ethanabraham639/Capstone-2025/README.md

# Capstone-2025

This can have a summary of what each folder contains
