ethanabraham639/Capstone-2025/electrical/README.md

# Electrical

This folder contains the schematic symbol library, pcb footprint library, schematic documents, pcbdoc, etc.
