ethanabraham639/Capstone-2025/electrical/Templates/PuttPilot.png

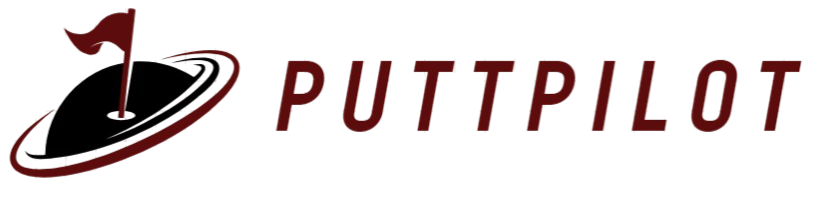
electrical/Templates/PuttPilot.png
