ethanabraham639/Capstone-2025/electrical/PuttPilot-Dev/PuttPilot-Dev.pdf

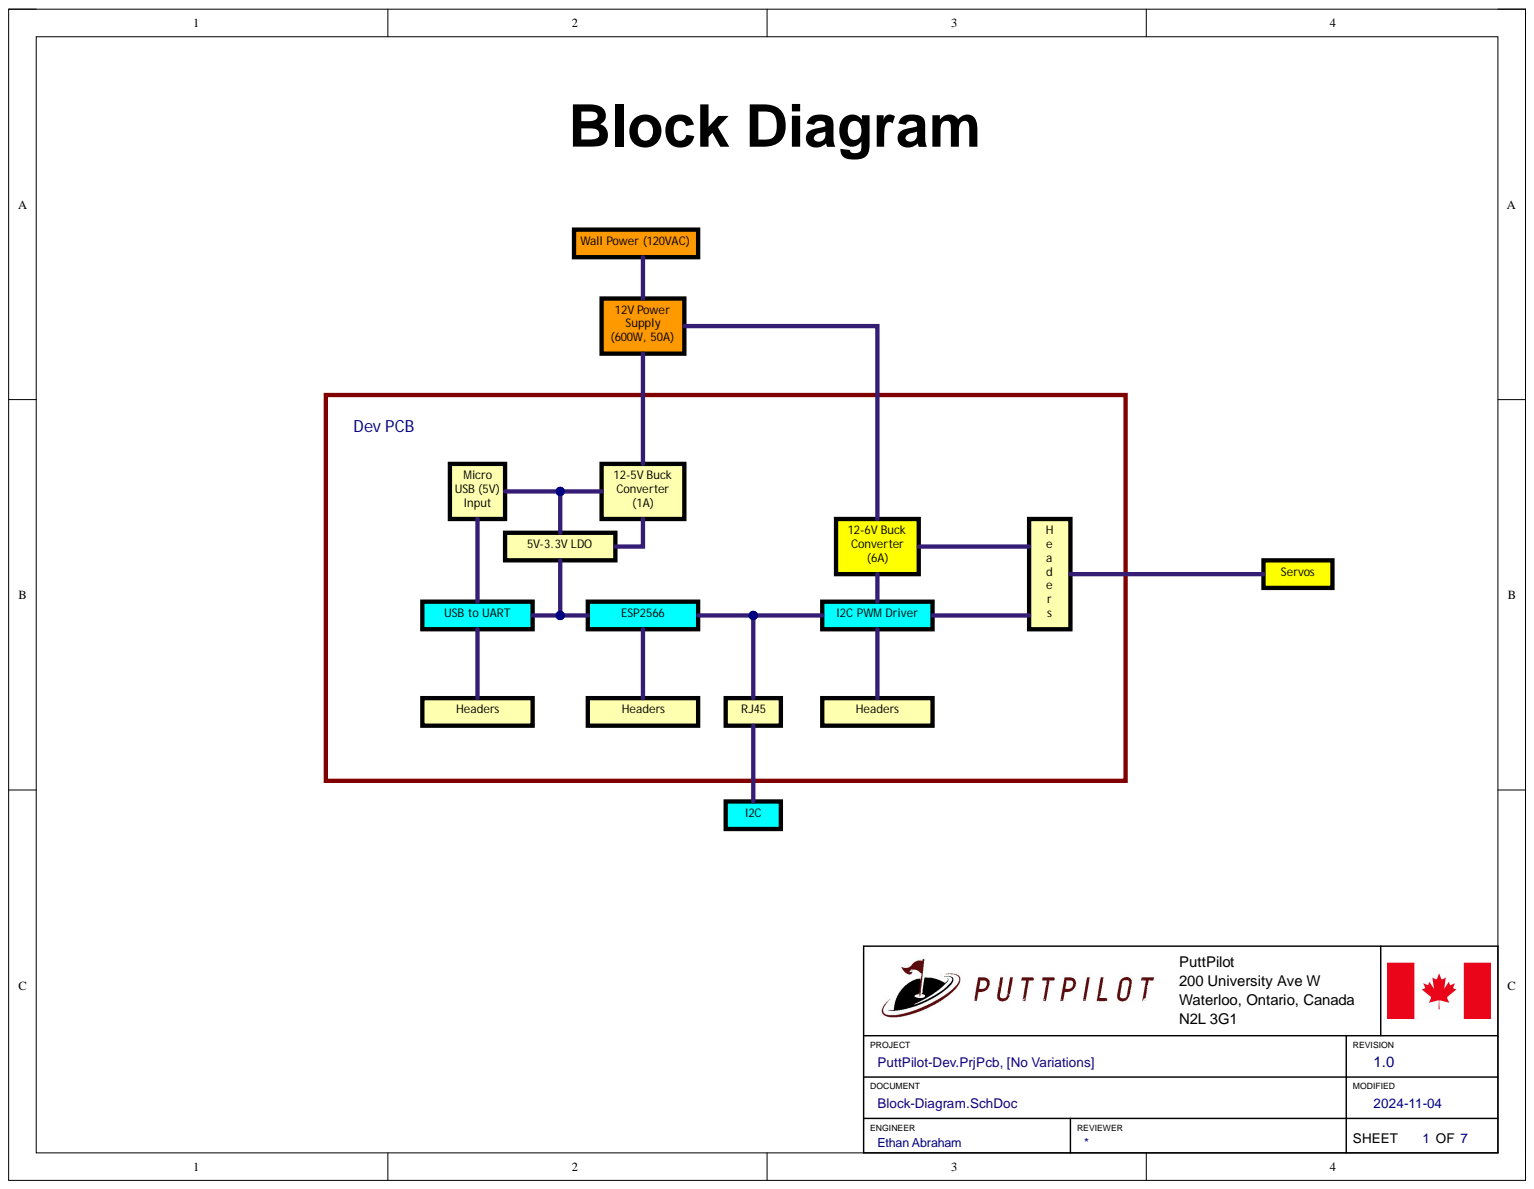
[picture p2: page 1]

PuttPilot 200 University Ave W Waterloo, Ontario, Canada N2L 3G1

PROJECT PuttPilot-Dev.PrjPcb, [No Variations] | REVISION 1.0

DOCUMENT Block-Diagram.SchDoc | MODIFIED 2024-11-04

ENGINEER E | REVIEWER * | SHEET 1 OF 7 than Abraham

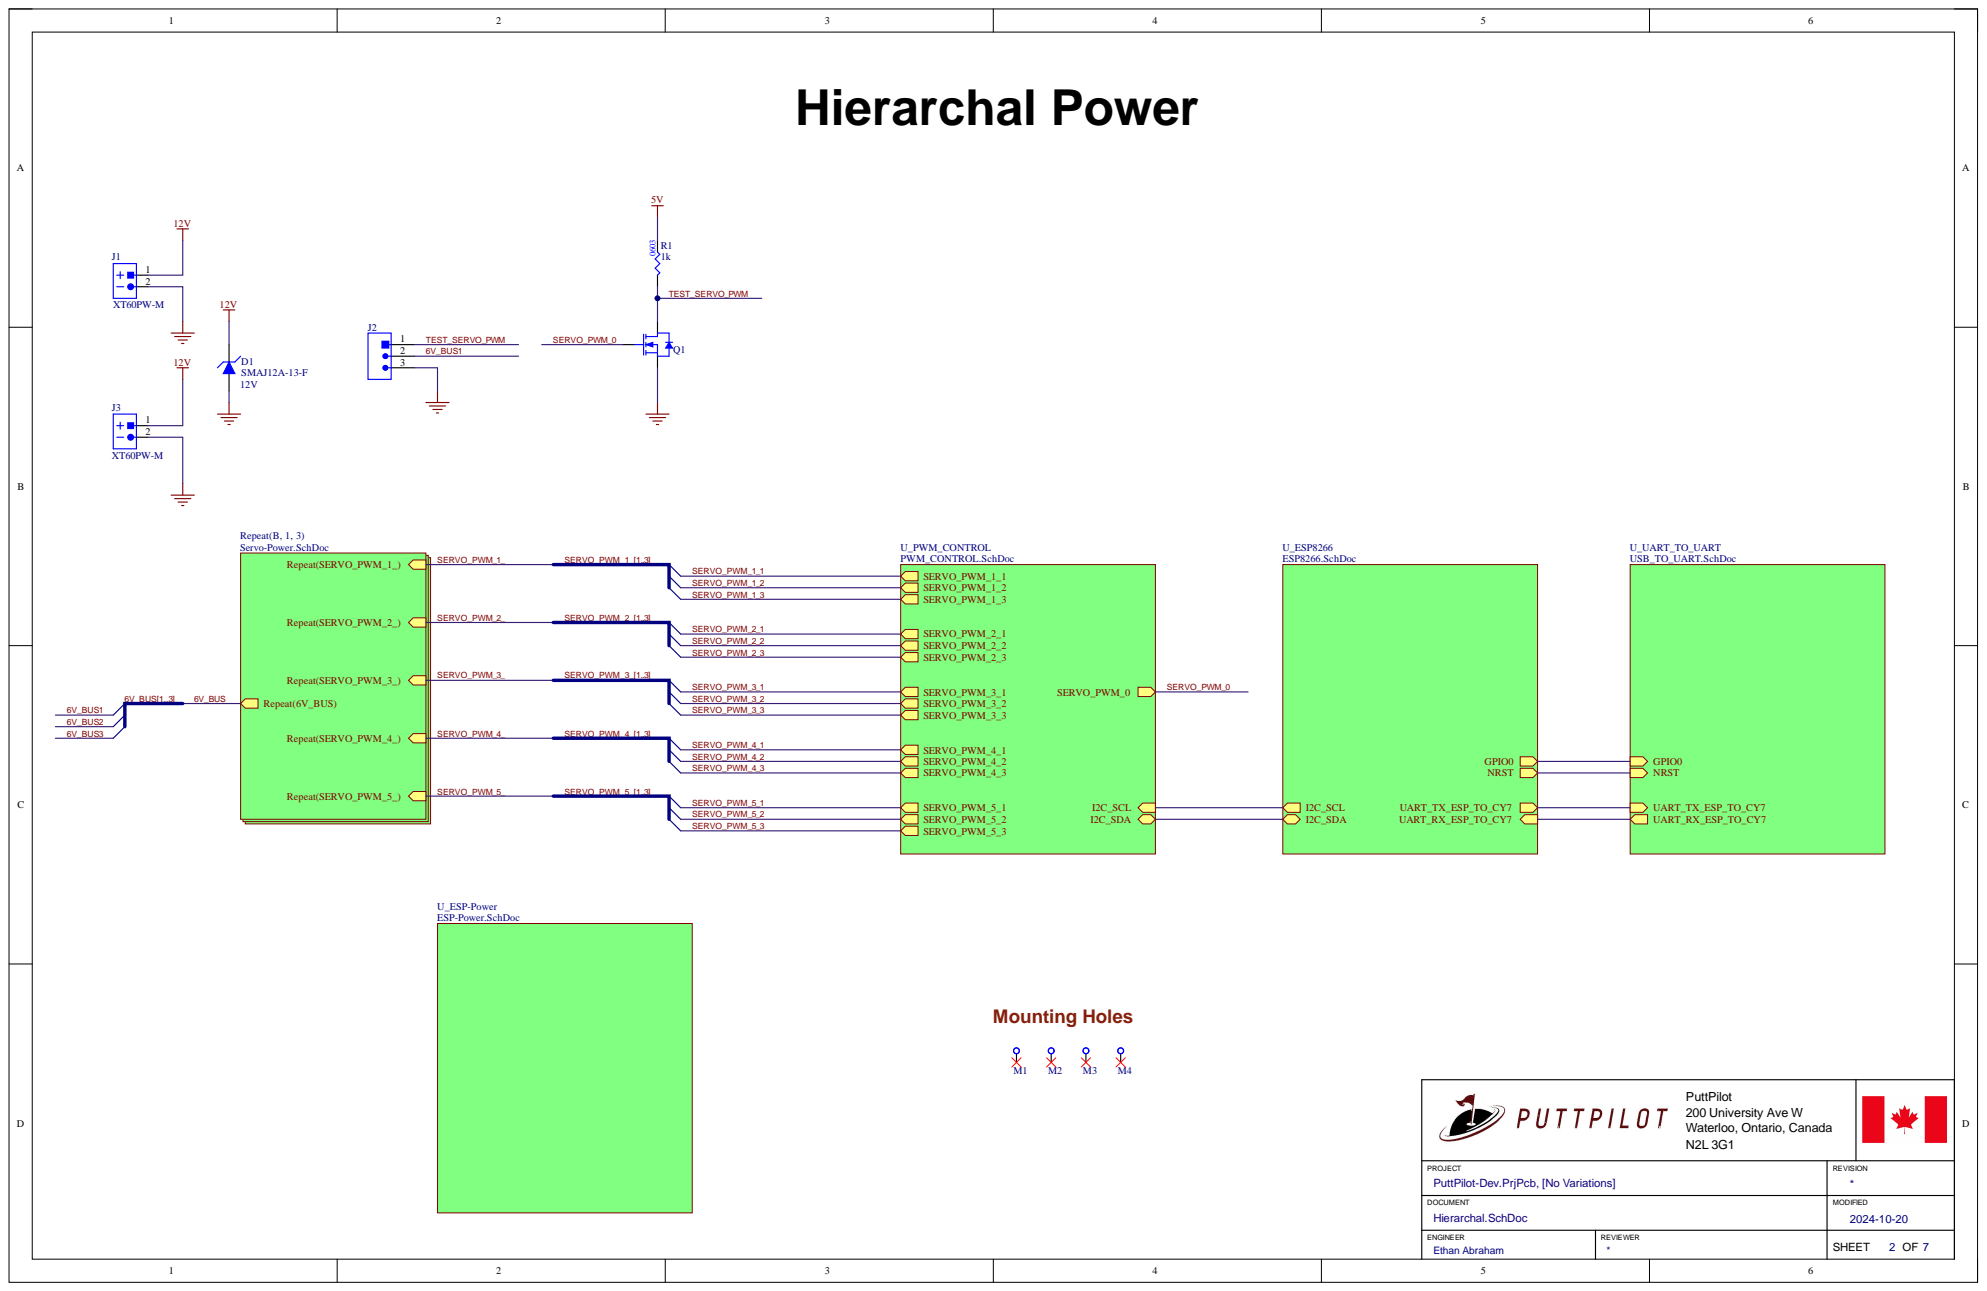
[picture p3: page 2]

PuttPilot 200 University Ave W Waterloo, Ontario, Canada N2L 3G1

PROJECT PuttPilot-Dev.PrjPcb, [No Variations] | REVISION *

DOCUMENT Hierarchal.SchDoc | MODIFIED 2024-10-20

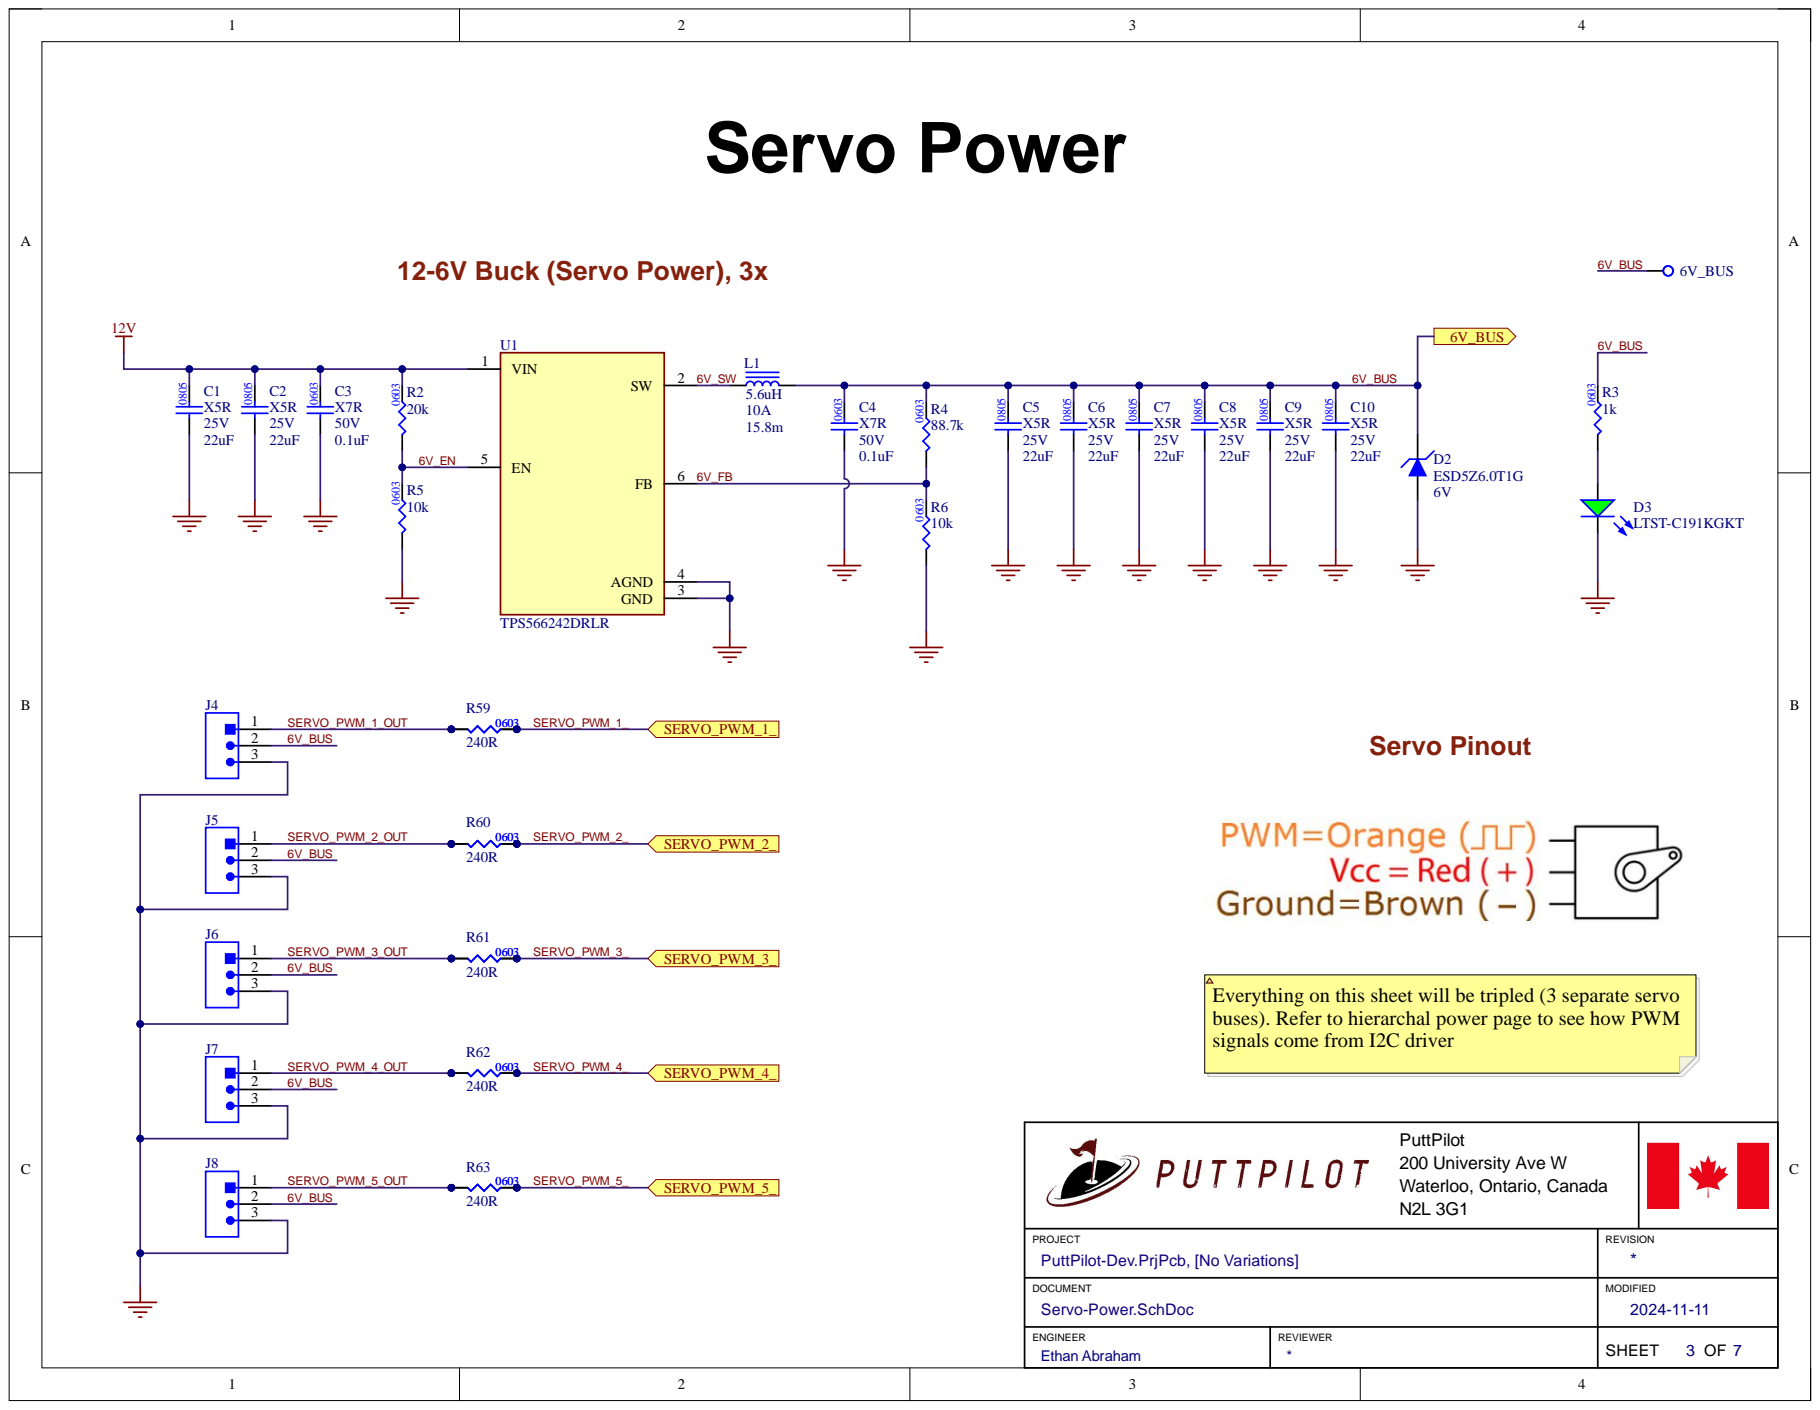
[picture p4: page 3]

Everything on this sheet will be tripled (3 separate servo
buses). Refer to hierarchal power page to see how PWM
signals come from I2C driver

PuttPilot 200 University Ave W Waterloo, Ontario, Canada N2L 3G1

PROJECT PuttPilot-Dev.PrjPcb, [No Variations] | REVISION *

DOCUMENT Servo-Power.SchDoc | MODIFIED

E | | 3 7 than Abraham

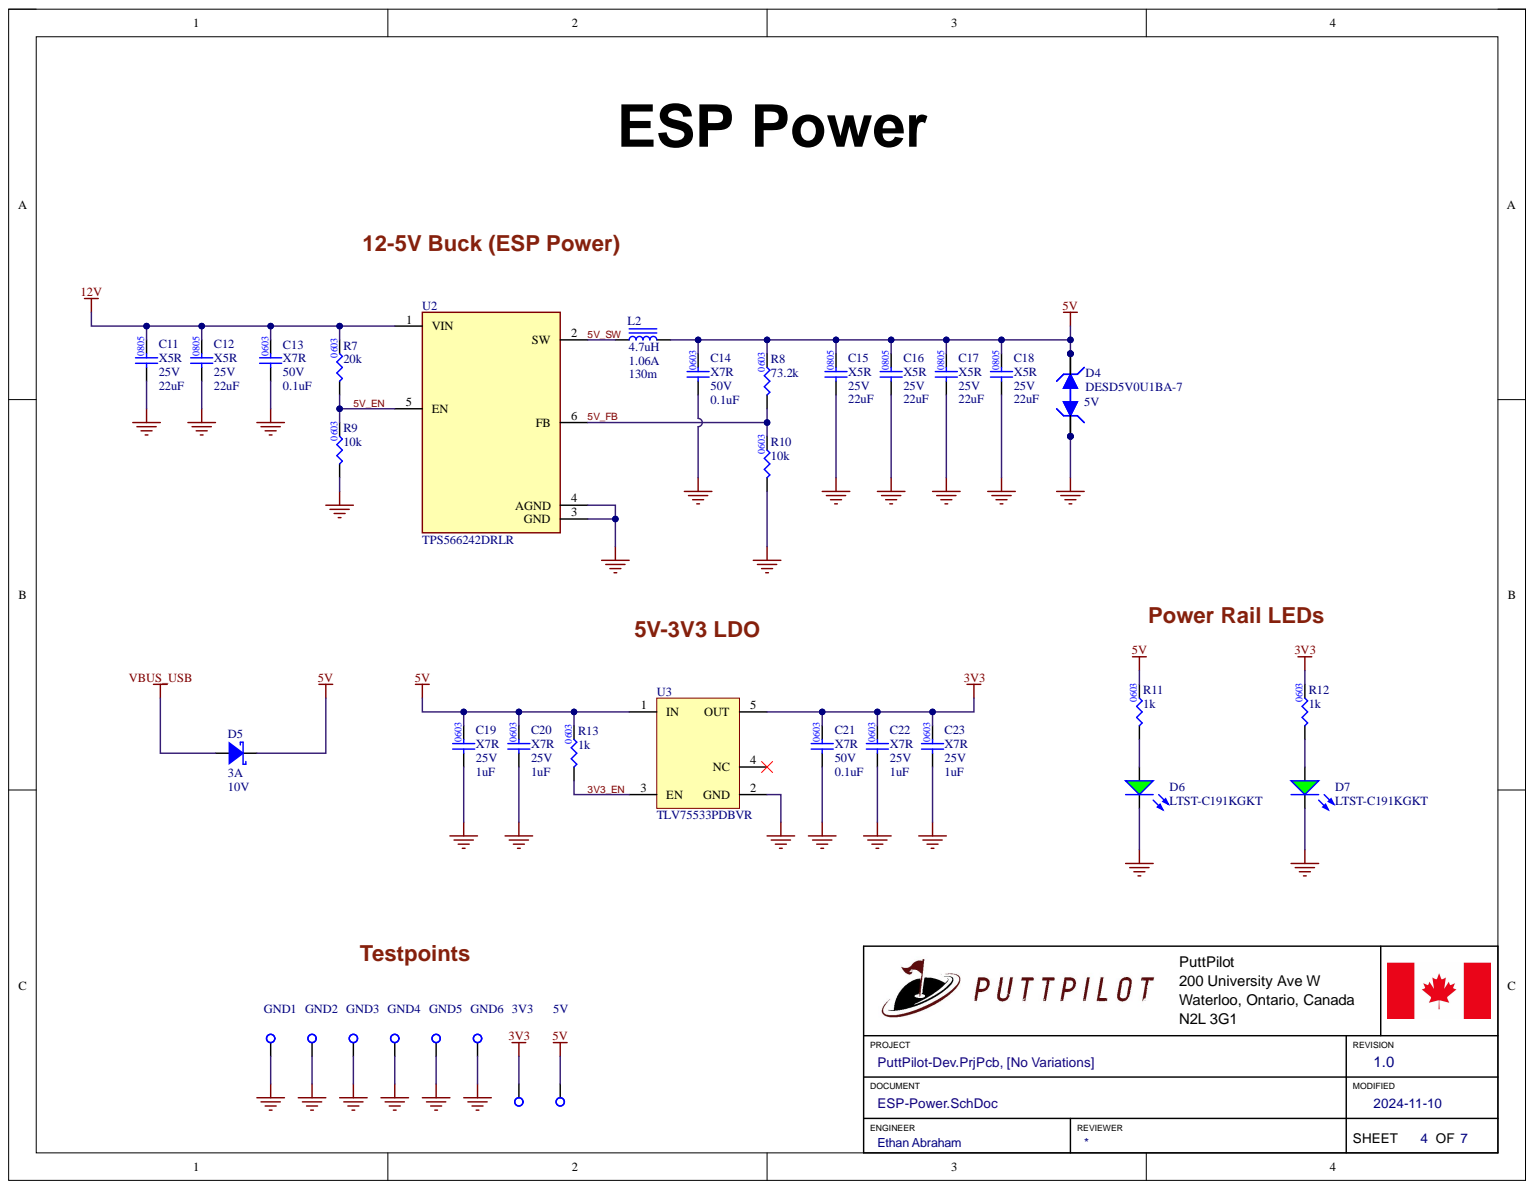
[picture p5: page 4]

PuttPilot 200 University Ave W Waterloo, Ontario, Canada N2L 3G1

PROJECT PuttPilot-Dev.PrjPcb, [No Variations] | REVISION 1.0

DOCUMENT ESP-Power.SchDoc | MODIFIED

E | | 4 7 than Abraham

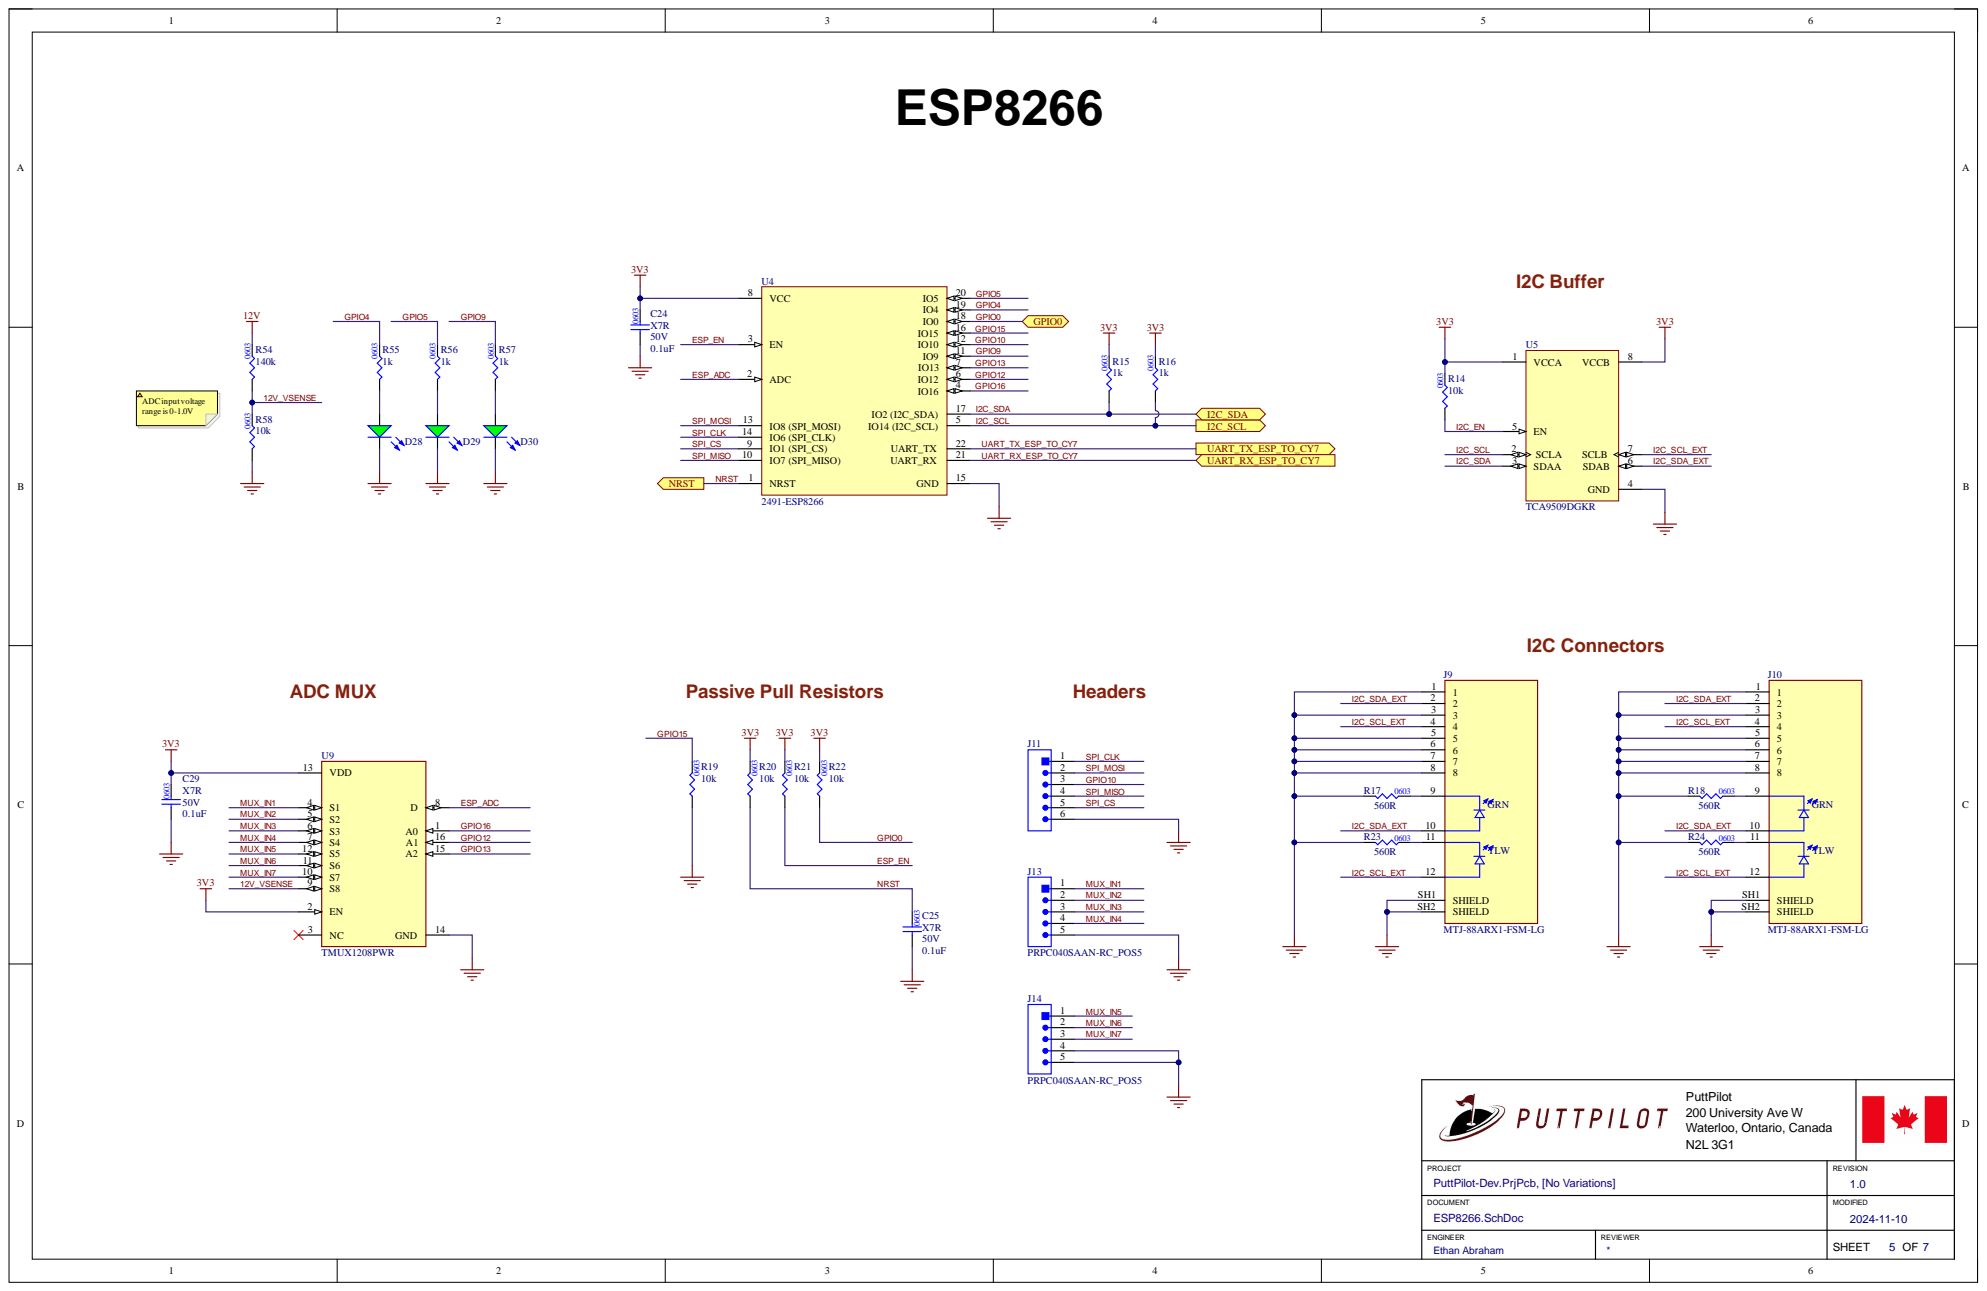
[picture p6: page 5]

PuttPilot 200 University Ave W Waterloo, Ontario, Canada N2L 3G1

PROJECT PuttPilot-Dev.PrjPcb, [No Variations] | REVISION 1.0

DOCUMENT ESP8266.SchDoc | MODIFIED 2024-11-10

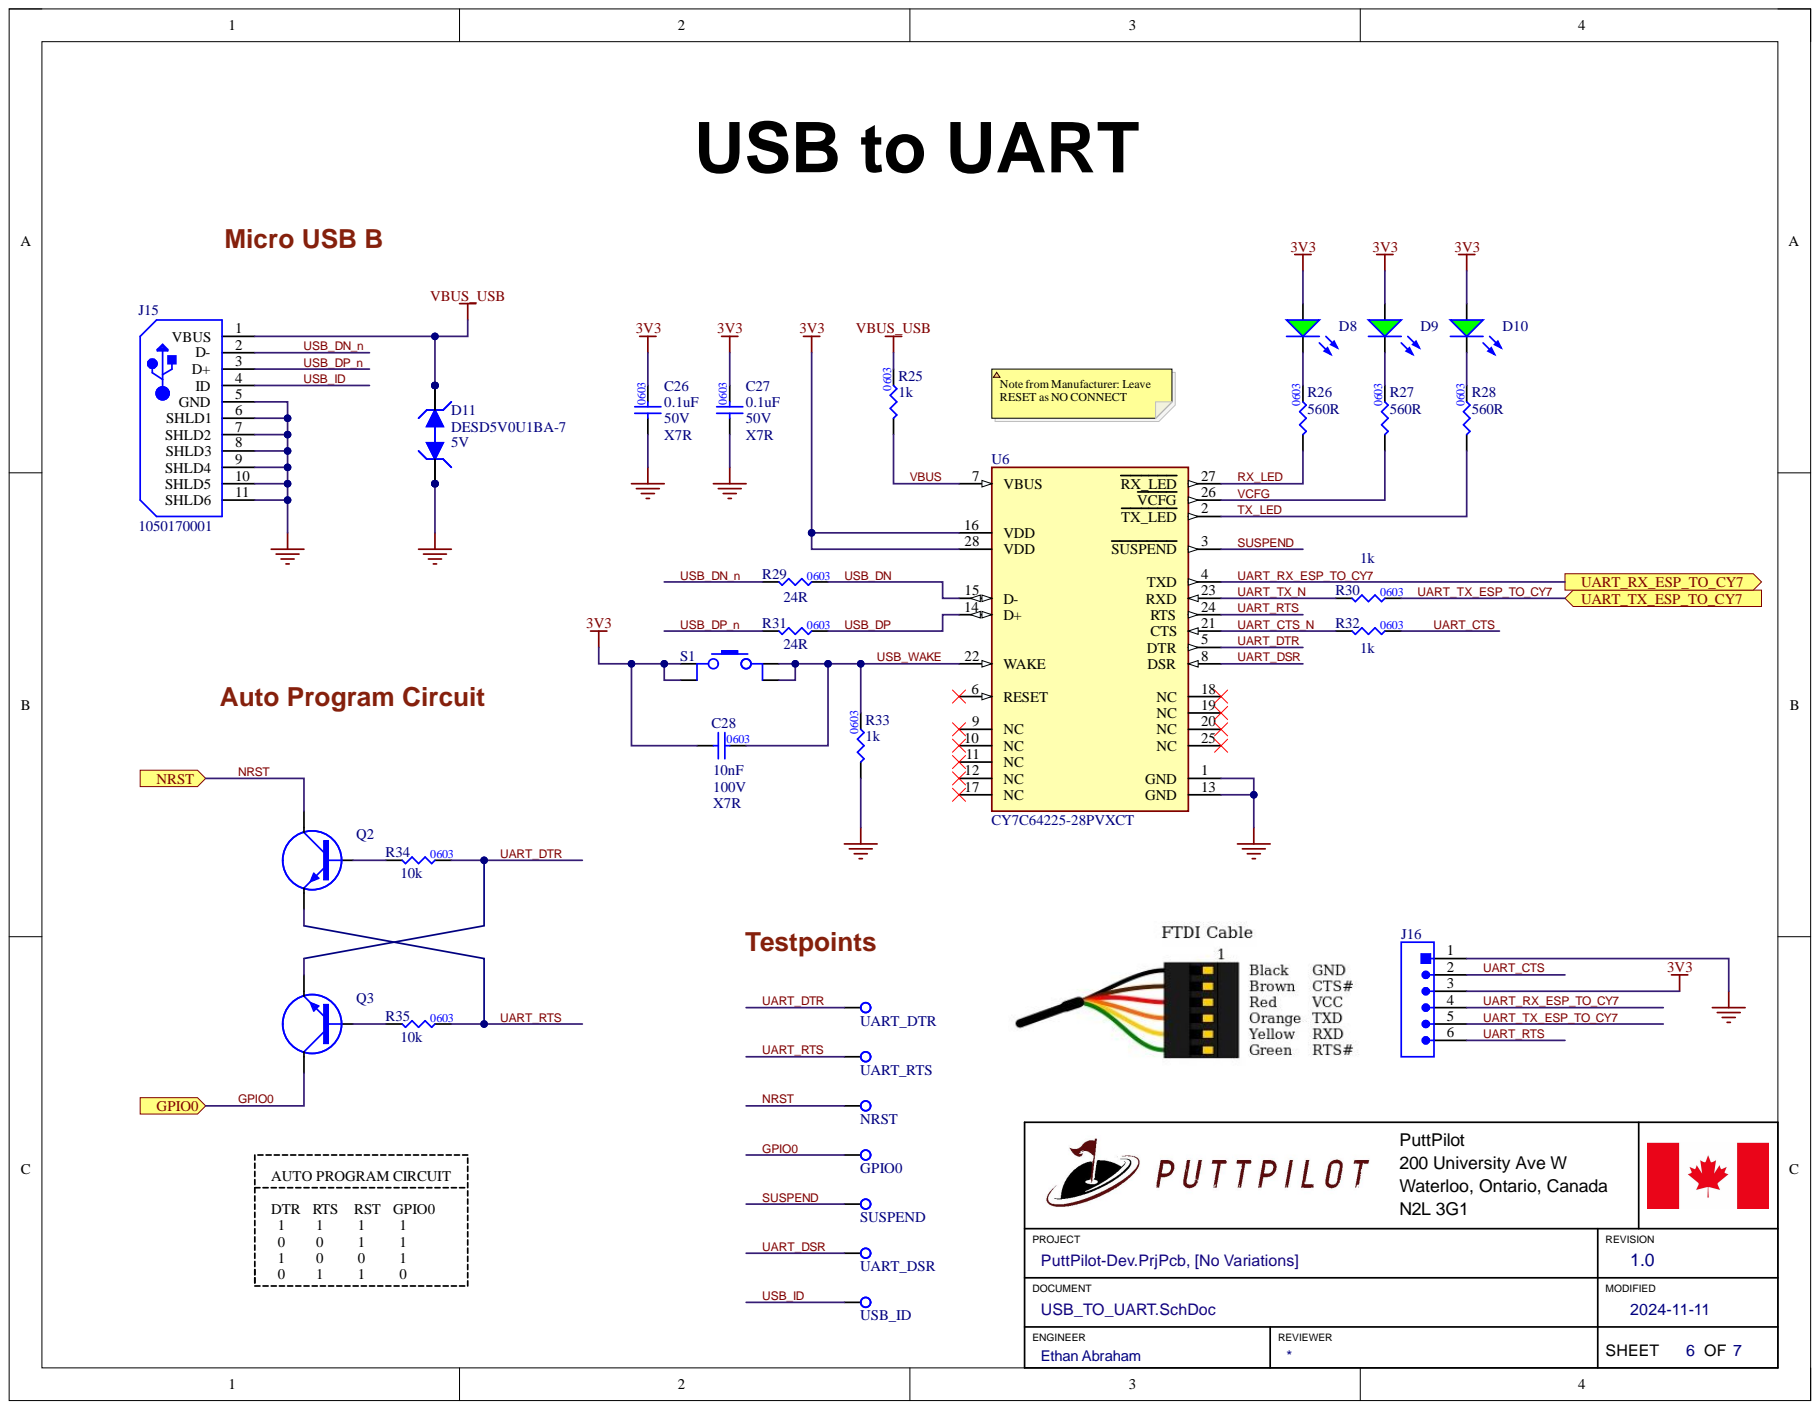
[picture p7: page 6]

Note from Manufacturer: Leave
RESET as NO CONNECT

USB_DP | WAKE 22

PuttPilot 200 University Ave W Waterloo, Ontario, Canada N2L 3G1

PROJECT PuttPilot-Dev.PrjPcb, [No Variations] | REVISION 1.0

DOCUMENT USB_TO_UART.SchDoc | MODIFIED

E | | 6 7 than Abraham

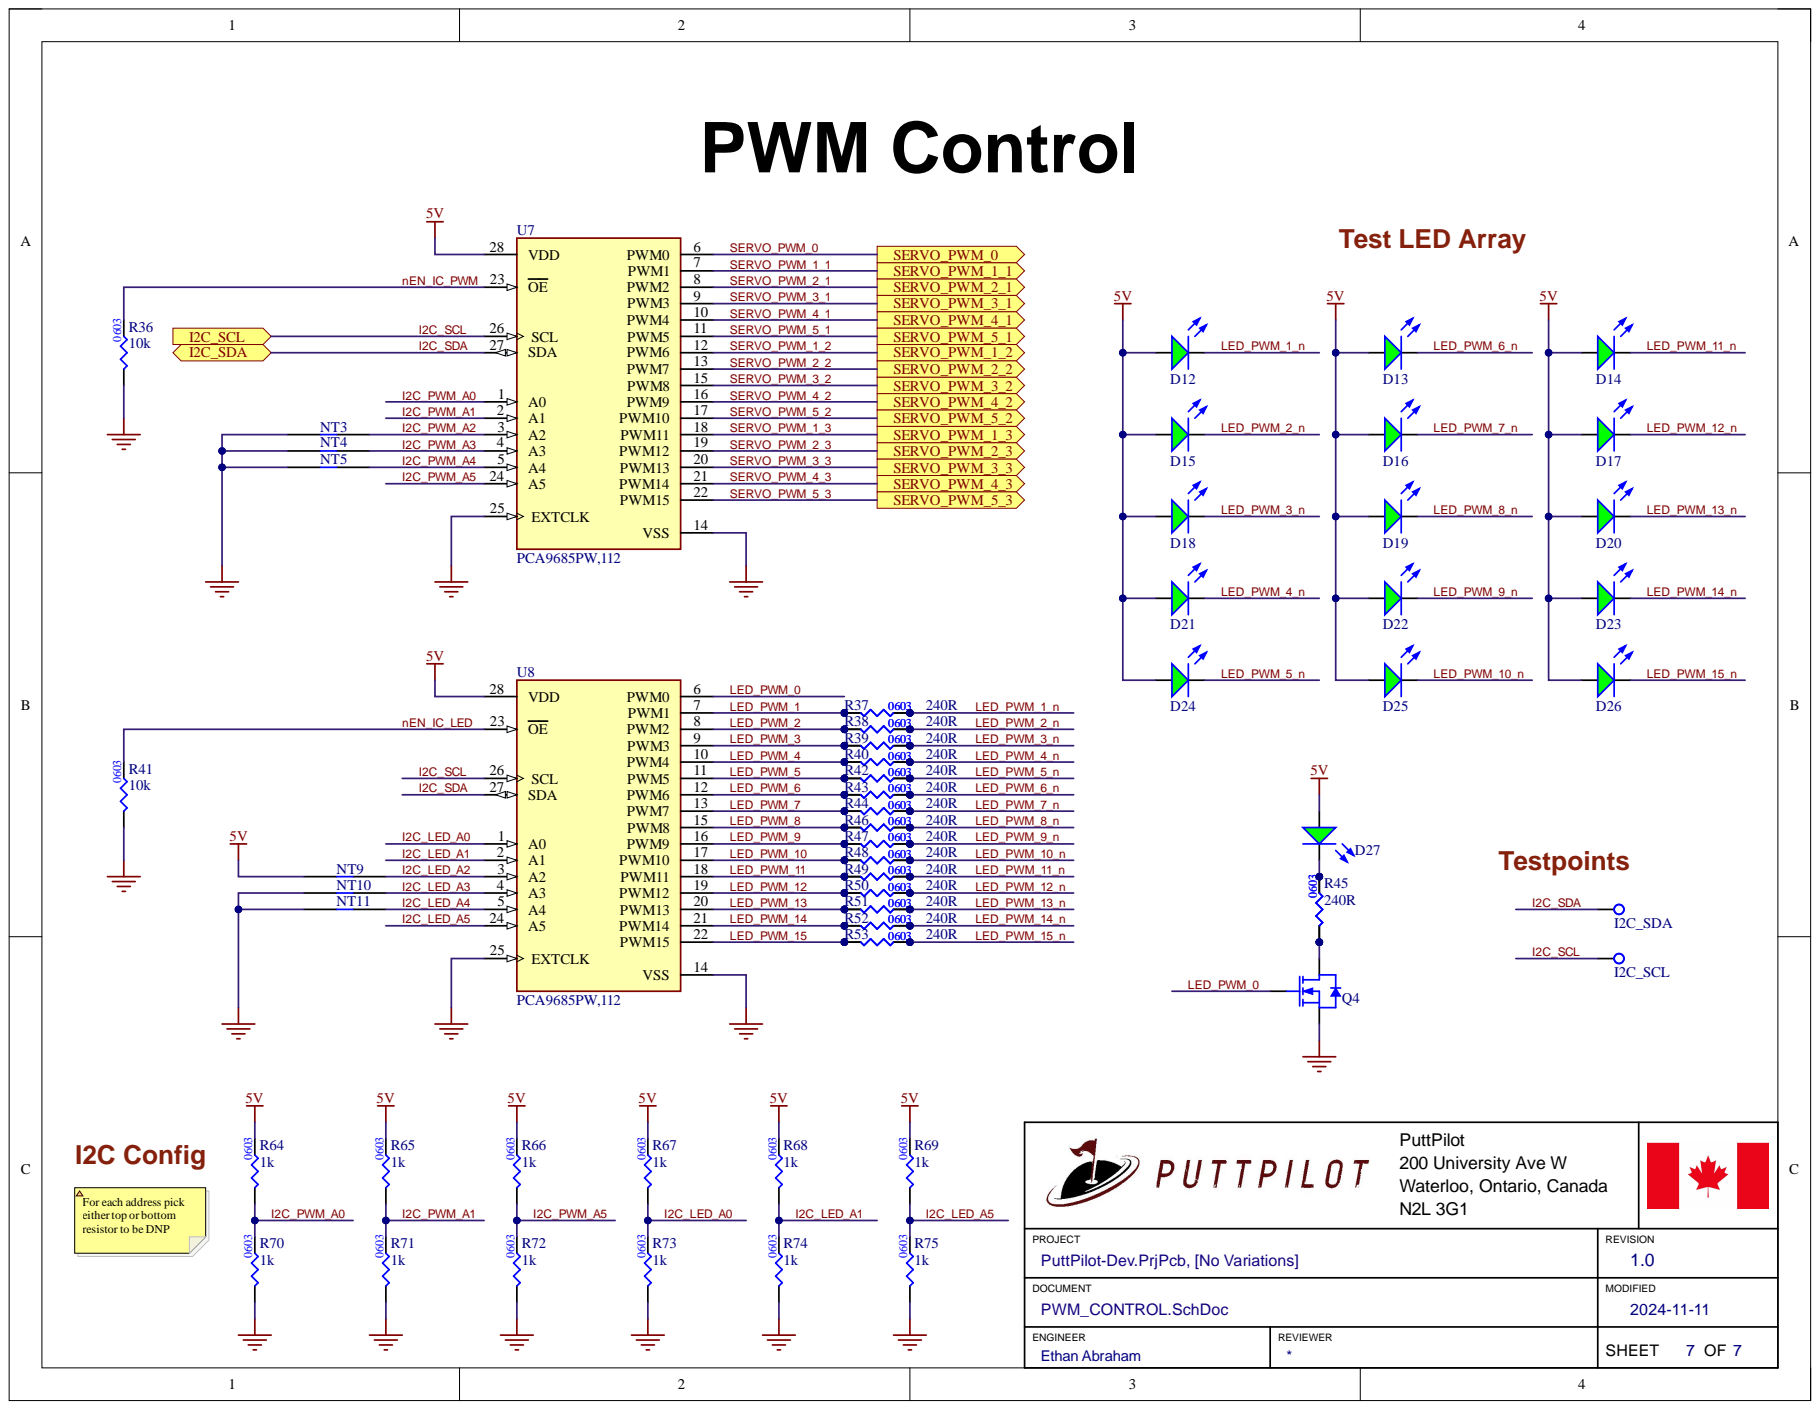
[picture p8: page 7]

NT4 I2C_PWM_A3 | A3 4
NT5 I2C_PWM_A4 | A4 5

I2C_PWM_A5 | A5 24

NT11 I2C_LED_A4 | A4 5

I2C_LED_A5 | A5 24

PuttPilot 200 University Ave W Waterloo, Ontario, Canada N2L 3G1

For each address pick
either top or bottom
resistor to be DNP

PROJECT PuttPilot-Dev.PrjPcb, [No Variations] | REVISION 1.0

DOCUMENT PWM_CONTROL.SchDoc | MODIFIED

E | | 7 7 than Abraham

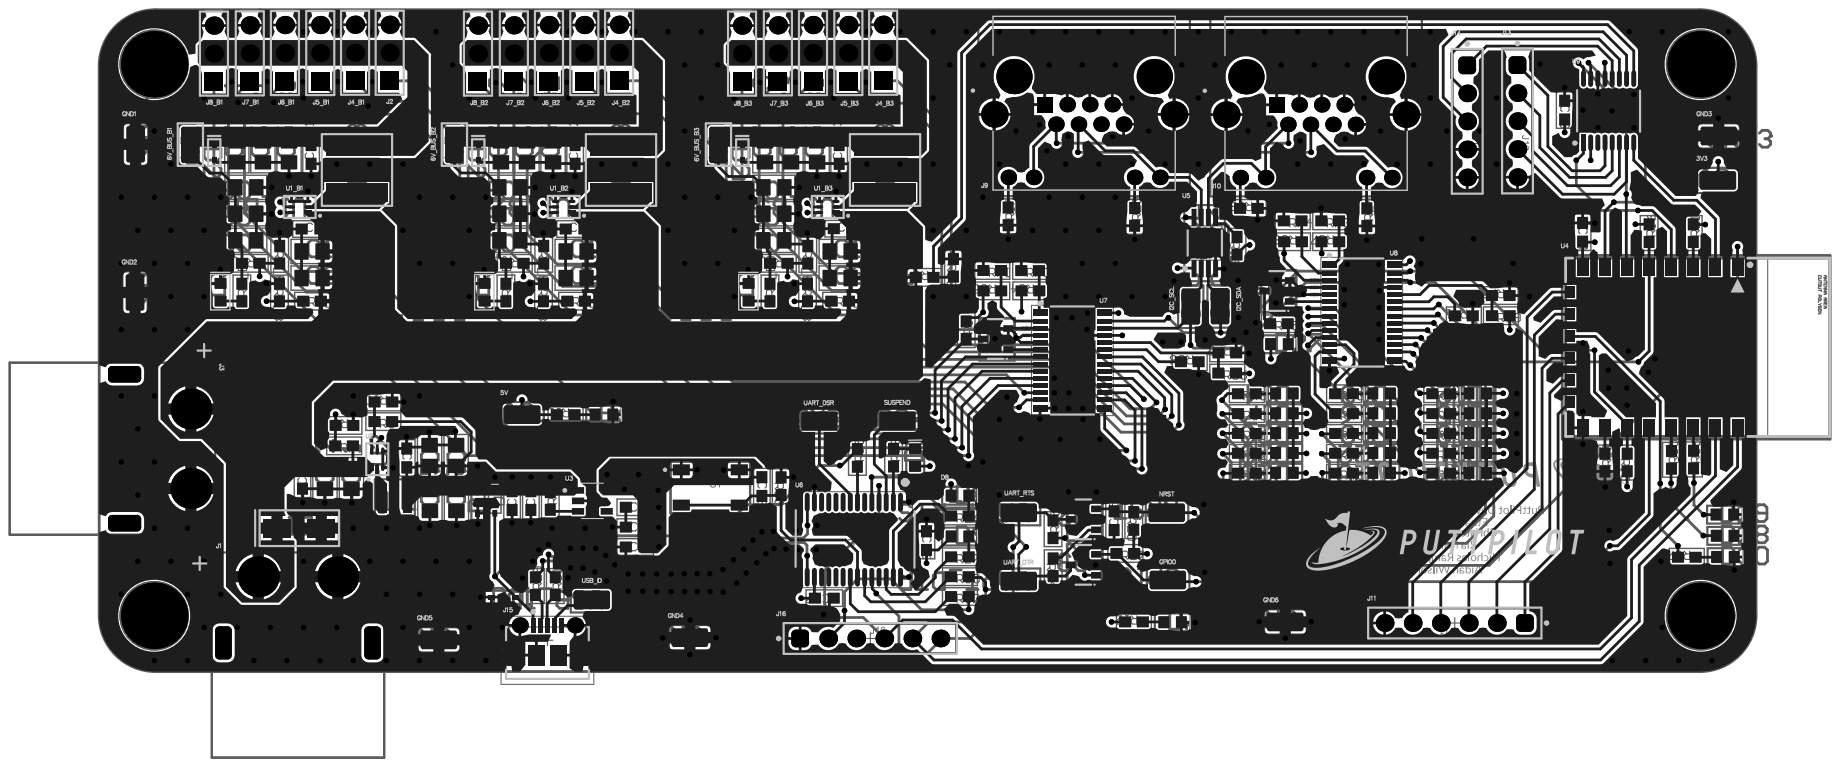
[picture p9: page 8]

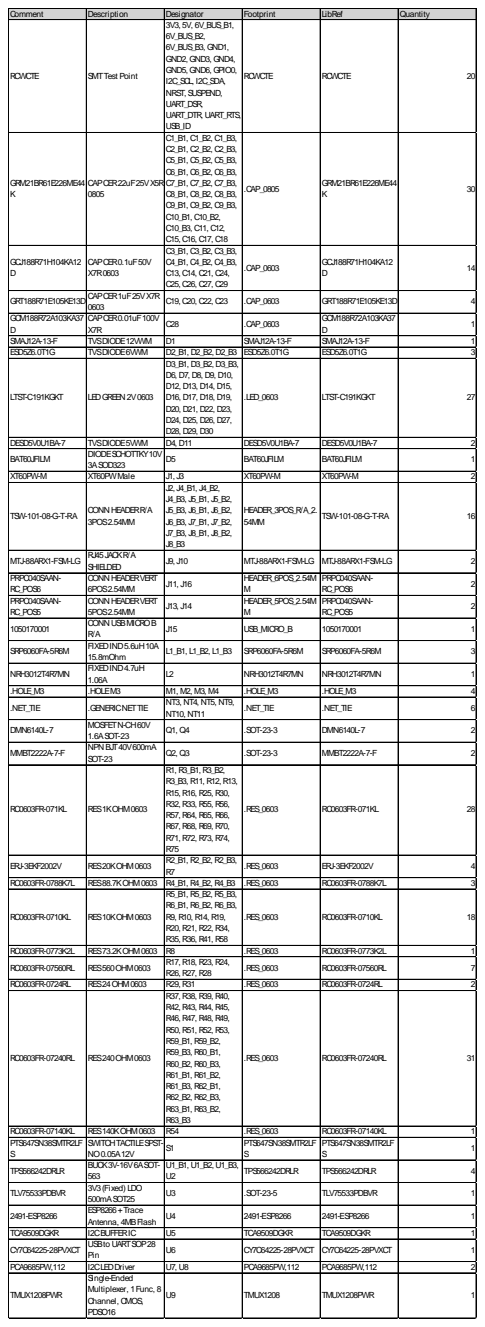
[picture p10: page 9]

Comment | Description | Designator | Footprint | LibRef | Quantity
RCWCTE | SMTTest Point | 3V3, 5V, 6V_BUS_B1, 6V_BUS_B2, 6V_BUS_B3, GND1, GND2, GND3, GND4, GND5, GND6, GPIO0, I2C_SCL, I2C_SDA, NRST, SUSPEND, UART_DSR, UART_DTR, UART_RTS, USB_ID | RCWCTE | RCWCTE | 20

GRM21BR61E226ME44 K | CAPCER22uF25VX5R 0805 | C1_B1, C1_B2, C1_B3, C2_B1, C2_B2, C2_B3, C5_B1, C5_B2, C5_B3, C6_B1, C6_B2, C6_B3, C7_B1, C7_B2, C7_B3, C8_B1, C8_B2, C8_B3, C9_B1, C9_B2, C9_B3, C10_B1, C10_B2, C10_B3, C11, C12, C15, C16, C17, C18 | .CAP_0805 | GRM21BR61E226ME44 K | 30

GCJ188R71H104KA12 D | CAPCER0.1uF50V X7R0603 | C3_B1, C3_B2, C3_B3, C4_B1, C4_B2, C4_B3, C13, C14, C21, C24, C25, C26, C27, C29 | .CAP_0603 | GCJ188R71H104KA12 D | 14

GRT188R71E105KE13D CAPCER1uF25VX7R | 0603 | C19, C20, C22, C23 | .CAP_0603 | GRT188R71E105KE13D | 4

GCM188R72A103KA37 D | CAPCER0.01uF100V X7R | C28 | .CAP_0603 | GCM188R72A103KA37 D | 1

SMAJ12A-13-F | TVSDIODE12VWM | D1 | SMAJ12A-13-F | SMAJ12A-13-F | 1
ESD5Z6.0T1G | TVSDIODE6VWM | D2_B1, D2_B2, D2_B3 | ESD5Z6.0T1G | ESD5Z6.0T1G | 3
LTST-C191KGKT | LEDGREEN 2V0603 | D3_B1, D3_B2, D3_B3, D6, D7, D8, D9, D10, D12, D13, D14, D15, D16, D17, D18, D19, D20, D21, D22, D23, D24, D25, D26, D27, D28, D29, D30 | .LED_0603 | LTST-C191KGKT | 27

DESD5V0U1BA-7 | TVSDIODE5VWM | D4, D11 | DESD5V0U1BA-7 | DESD5V0U1BA-7 | 2
BAT60JFILM | DIODESCHOTTKY10V 3ASOD323 | D5 | BAT60JFILM | BAT60JFILM | 1

XT60PW-M | XT60PWMale | J1, J3 | XT60PW-M | XT60PW-M | 2
TSW-101-08-G-T-RA | CONN HEADERR/A 3POS2.54MM | J2, J4_B1, J4_B2, J4_B3, J5_B1, J5_B2, J5_B3, J6_B1, J6_B2, J6_B3, J7_B1, J7_B2, J7_B3, J8_B1, J8_B2, J8_B3 | HEADER_3POS_R/A_2. 54MM | TSW-101-08-G-T-RA | 16

MTJ-88ARX1-FSM-LG | RJ45JACKR/A SHIELDED | J9, J10 | MTJ-88ARX1-FSM-LG | MTJ-88ARX1-FSM-LG | 2

PRPC040SAAN-RC_POS6 | CONN HEADERVERT 6POS2.54MM | J11, J16 | HEADER_6POS_2.54M M | PRPC040SAAN-RC_POS6 | 2

PRPC040SAAN-RC_POS5 | CONN HEADERVERT 5POS2.54MM | J13, J14 | HEADER_5POS_2.54M M | PRPC040SAAN-RC_POS5 | 2

1050170001 | CONN USBMICROB R/A | J15 | USB_MICRO_B | 1050170001 | 1

SRP6060FA-5R6M | FIXEDIND5.6uH10A 15.8mOhm | L1_B1, L1_B2, L1_B3 | SRP6060FA-5R6M | SRP6060FA-5R6M | 3

NRH3012T4R7MN | FIXEDIND4.7uH 1.06A | L2 | NRH3012T4R7MN | NRH3012T4R7MN | 1

.HOLE_M3 | .HOLEM3 | M1, M2, M3, M4 | .HOLE_M3 | .HOLE_M3 | 4
.NET_TIE | .GENERICNETTIE | NT3, NT4, NT5, NT9, NT10, NT11 | .NET_TIE | .NET_TIE | 6

DMN6140L-7 | MOSFETN-CH60V 1.6ASOT-23 | Q1, Q4 | .SOT-23-3 | DMN6140L-7 | 2

MMBT2222A-7-F | NPN BJT40V600mA SOT-23 | Q2, Q3 | .SOT-23-3 | MMBT2222A-7-F | 2

RC0603FR-071KL | RES1KOHM0603 | R1, R3_B1, R3_B2, R3_B3, R11, R12, R13, R15, R16, R25, R30, R32, R33, R55, R56, R57, R64, R65, R66, R67, R68, R69, R70, R71, R72, R73, R74, R75 | .RES_0603 | RC0603FR-071KL | 28

ERJ-3EKF2002V | RES20KOHM0603 | R2_B1, R2_B2, R2_B3, R7 | .RES_0603 | ERJ-3EKF2002V | 4

RC0603FR-0788K7L | RES88.7KOHM0603 | R4_B1, R4_B2, R4_B3 | .RES_0603 | RC0603FR-0788K7L | 3
RC0603FR-0710KL | RES10KOHM0603 | R5_B1, R5_B2, R5_B3, R6_B1, R6_B2, R6_B3, R9, R10, R14, R19, R20, R21, R22, R34, R35, R36, R41, R58 | .RES_0603 | RC0603FR-0710KL | 18

RC0603FR-0773K2L | RES73.2KOHM0603 | R8 | .RES_0603 | RC0603FR-0773K2L | 1
RC0603FR-07560RL | RES560OHM0603 | R17, R18, R23, R24, R26, R27, R28 | .RES_0603 | RC0603FR-07560RL | 7

RC0603FR-0724RL | RES24OHM0603 | R29, R31 | .RES_0603 | RC0603FR-0724RL | 2
RC0603FR-07240RL | RES240OHM0603 | R37, R38, R39, R40, R42, R43, R44, R45, R46, R47, R48, R49, R50, R51, R52, R53, R59_B1, R59_B2, R59_B3, R60_B1, R60_B2, R60_B3, R61_B1, R61_B2, R61_B3, R62_B1, R62_B2, R62_B3, R63_B1, R63_B2, R63_B3 | .RES_0603 | RC0603FR-07240RL | 31

RC0603FR-07140KL | RES140KOHM0603 | R54 | .RES_0603 | RC0603FR-07140KL | 1
PTS647SN38SMTR2LF S | SWITCHTACTILESPST-NO0.05A12V | S1 | PTS647SN38SMTR2LF S | PTS647SN38SMTR2LF S | 1

TPS566242DRLR | BUCK3V-16V6ASOT-563 | U1_B1, U1_B2, U1_B3, U2 | TPS566242DRLR | TPS566242DRLR | 4

TLV75533PDBVR | 3V3(Fixed) LDO 500mASOT25 | U3 | .SOT-23-5 | TLV75533PDBVR | 1

2491-ESP8266 | ESP8266+Trace Antenna, 4MBFlash | U4 | 2491-ESP8266 | 2491-ESP8266 | 1

TCA9509DGKR | I2CBUFFERIC | U5 | TCA9509DGKR | TCA9509DGKR | 1
CY7C64225-28PVXCT | USBto UARTSOP28 Pin | U6 | CY7C64225-28PVXCT | CY7C64225-28PVXCT | 1

PCA9685PW,112 | I2CLEDDriver | U7, U8 | PCA9685PW,112 | PCA9685PW,112 | 2
TMUX1208PWR | Single-Ended Multiplexer, 1Func, 8 Channel, CMOS, PDSO16 | U9 | TMUX1208 | TMUX1208PWR | 1
