ethanabraham639/Capstone-2025/(list of files, drawings)

Other design files:
electrical/PuttPilot-Dev/Block-Diagram.SchDoc
electrical/PuttPilot-Dev/ESP8266.SchDoc
electrical/PuttPilot-Dev/ESP-Power.SchDoc
electrical/PuttPilot-Dev/Hierarchal.SchDoc
electrical/PuttPilot-Dev/PuttPilot-Dev.PrjPcb
electrical/PuttPilot-Dev/PuttPilot.PcbLib
electrical/PuttPilot-Dev/PuttPilot.SchLib
electrical/PuttPilot-Dev/PWM_CONTROL.SchDoc
electrical/PuttPilot-Dev/Servo-Power.SchDoc
electrical/PuttPilot-Dev/USB_TO_UART.SchDoc
electrical/PuttPilot-Master/Block-Diagram.SchDoc
electrical/PuttPilot-Master/ESP8266.SchDoc
electrical/PuttPilot-Master/ESP-Power.SchDoc
electrical/PuttPilot-Master/Hierarchal.SchDoc
electrical/PuttPilot-Master/PuttPilot-Master.PrjPcb
electrical/PuttPilot-Master/PuttPilot.PcbLib
electrical/PuttPilot-Master/PuttPilot.SchLib
electrical/PuttPilot-Master/PWM_CONTROL.SchDoc
electrical/PuttPilot-Master/Servo-Power.SchDoc
electrical/PuttPilot-Master/USB_TO_UART.SchDoc
electrical/PuttPilot-Node/Block-Diagram.SchDoc
electrical/PuttPilot-Node/Connectors.SchDoc
electrical/PuttPilot-Node/Hierarchal.SchDoc
electrical/PuttPilot-Node/PuttPilot-Node.PrjPcb
electrical/PuttPilot-Node/PuttPilot.PcbLib
electrical/PuttPilot-Node/PuttPilot.SchLib
electrical/PuttPilot-Node/PWM-Power.SchDoc
electrical/PuttPilot-Node/PWM_CONTROL.SchDoc
electrical/PuttPilot-Node/Servo-Power.SchDoc
