ethanabraham639/Capstone-2025/firmware/app/src/sensors.c

#include "sensors.h"

#include "freertos/FreeRTOS.h"
#include "freertos/task.h"


#include "gpio.h"
#include "delay.h"

#define DEBOUNCE_DELAY_MS       15
#define SENSOR_TASK_DELAY_MS    1

typedef struct{
    gpio_num_t gpio;
    int confirmed_level;

    bool detected;
    bool confirmed;
    Timer_t timer;
} GpioSensor_t;

typedef struct {
    GpioSensor_t BIH;
    GpioSensor_t BIG;
    GpioSensor_t BD;
    GpioSensor_t BQ;
} Sensors_t;

volatile Sensors_t sensors = {.BIH.gpio = BIH_GPIO_IN, .BIH.confirmed_level = GPIO_LOW, .BIH.detected = false, .BIH.confirmed = false, .BIH.timer = 0,
                              .BIG.gpio = BIG_GPIO_IN, .BIG.confirmed_level = GPIO_LOW, .BIG.detected = false, .BIG.confirmed = false, .BIG.timer = 0,
                              .BD.gpio  = BD_GPIO_IN , .BD.confirmed_level  = GPIO_HIGH, .BD.detected  = false, .BD.confirmed  = false, .BD.timer  = 0,
                              .BQ.gpio  = BQ_GPIO_IN, .BQ.confirmed_level   = GPIO_HIGH, .BQ.detected  = false, .BQ.confirmed  = false, .BQ.timer  = 0};


// Common ISR
static void sensor_gpio_isr_handler(void* arg)
{
    uint32_t gpio_num = (uint32_t) arg;

    switch (gpio_num)
    {
        case BIH_GPIO_IN:
            sensors.BIH.detected = true;
            sensors.BIH.timer = TIMER_restart();
            break;

        case BIG_GPIO_IN:
            sensors.BIG.detected = true;
            sensors.BIG.timer = TIMER_restart();
            break;

        case BD_GPIO_IN:
            sensors.BD.detected = true;
            sensors.BD.timer = TIMER_restart();
            break;

        case BQ_GPIO_IN:
            sensors.BQ.detected = true;
            sensors.BQ.timer = TIMER_restart();
            break;
    }
}

void generic_gpio_debounce_read(volatile GpioSensor_t* sensor, uint32_t debounceTime)
{
    if (sensor->detected && !sensor->confirmed)
    {
        int gpio_level = gpio_get_level(sensor->gpio);

        if (gpio_level == sensor->confirmed_level)
        {
            if (TIMER_get_ms(sensor->timer) > debounceTime)
            {
                sensor->confirmed = true;
            }
        }
        else
        {
            sensor->detected = false;
        }
    }
}

void check_ball_in_hole(void)
{
    generic_gpio_debounce_read(&(sensors.BIH), DEBOUNCE_DELAY_MS);
}

void check_ball_in_gutter(void)
{
    generic_gpio_debounce_read(&(sensors.BIG), DEBOUNCE_DELAY_MS);
}

void check_ball_dep(void)
{
    generic_gpio_debounce_read(&(sensors.BD), DEBOUNCE_DELAY_MS);
}

void check_ball_queue(void)
{
    generic_gpio_debounce_read(&(sensors.BQ), 10);
}

void SNS_init(void)
{
    gpio_install_isr_service(0);

    gpio_isr_handler_add(BIH_GPIO_IN, sensor_gpio_isr_handler, (void *) BIH_GPIO_IN);
    gpio_isr_handler_add(BIG_GPIO_IN, sensor_gpio_isr_handler, (void *) BIG_GPIO_IN);
    gpio_isr_handler_add(BD_GPIO_IN, sensor_gpio_isr_handler, (void *) BD_GPIO_IN);
    gpio_isr_handler_add(BQ_GPIO_IN, sensor_gpio_isr_handler, (void *) BQ_GPIO_IN);
    
    gpio_set_level(16, 1);


}

bool SNS_get_ball_in_hole(void)
{
    return sensors.BIH.confirmed;
}

void SNS_clear_ball_in_hole(void)
{
    sensors.BIH.confirmed = false;
    sensors.BIH.detected = false;
}

bool SNS_get_ball_in_gutter(void)
{
    return sensors.BIG.confirmed;
}

void SNS_clear_ball_in_gutter(void)
{
    sensors.BIG.confirmed = false;
    sensors.BIG.detected = false;
}

bool SNS_get_ball_dep(void)
{
    return sensors.BD.confirmed;
}

void SNS_clear_ball_dep(void)
{
    sensors.BD.confirmed = false;
    sensors.BD.detected = false;
    }

bool SNS_get_ball_queue(void)
{
    return sensors.BQ.confirmed;
}

void SNS_clear_ball_queue(void)
{
    sensors.BQ.confirmed = false;
    sensors.BQ.detected = false;
}

void SNS_run_task(void)
{
    check_ball_in_hole();
    check_ball_in_gutter();
    check_ball_dep();
    check_ball_queue();
}
