ethanabraham639/Capstone-2025/firmware/app/src/delay.c

#include "delay.h"
#include "esp_timer.h"

#include <math.h>

#define US_TO_MS 1000

int64_t TIMER_restart()
{
    return esp_timer_get_time();
}

int64_t TIMER_get_ms(Timer_t timer)
{
    return round((esp_timer_get_time() - timer) / US_TO_MS);
}

int64_t TIMER_get_us(Timer_t timer)
{
    return (esp_timer_get_time() - timer);
}
