ethanabraham639/Capstone-2025/software/testServer_ESP8266.ino

#include <ESP8266WiFi.h>

const char* ssid = "McAbsfi";
const char* password = "aidanMcLoves___";

WiFiServer server(80);

void setup() {
  Serial.begin(115200);
  delay(10);

  // Connect to WiFi network
  Serial.println();
  Serial.println();
  Serial.print("Connecting to ");
  Serial.println(ssid);

  WiFi.begin(ssid, password);

  while (WiFi.status() != WL_CONNECTED) {
    delay(500);
    Serial.print(".");
  }

  Serial.println("");
  Serial.println("WiFi connected");
  Serial.println("IP address: ");
  Serial.println(WiFi.localIP());

  // Start the server
  server.begin();
  Serial.println("Server started");
}

void loop() {
  WiFiClient client = server.available(); // Listen for incoming clients

  if (client) {
    Serial.println("New Client.");
    String currentLine = "";
    while (client.connected()) {
      if (client.available()) {
        char c = client.read();
        Serial.write(c);
        if (c == '\n') {
          // If the current line is blank, you got two newline characters in a row.
          // That's the end of the client HTTP request, so send a response.
          if (currentLine.length() == 0) {
            // Send a standard HTTP response
            client.println("HTTP/1.1 200 OK");
            client.println("Content-type:text/html");
            client.println();
            client.println("<!DOCTYPE HTML>");
            client.println("<html>");
            client.println("<h1>Hello from ESP8266 and Ethan Ria and Chris</h1>");
            client.println("</html>");
            client.println();
            break;
          } else {
            currentLine = "";
          }
        } else if (c != '\r') {
          currentLine += c;
        }
      }
    }
    client.stop();
    Serial.println("Client Disconnected.");
  }
}
