ethanabraham639/Capstone-2025/(commit log)

2024-04-18 Create Altium project
    [Block-Diagram.SchDoc, Capstone-2025.PrjPcb]
2024-04-18 Primary power source
    [Block-Diagram.SchDoc]
2024-04-20 Create schematic library with resistor and capacitor templates
    [Capstone-2025.SchLib]
2024-04-24 Create footprint templates for common resistors and caps
    [Capstone-2025.PcbLib]
2024-04-24 EE: Create component links between symbols and footprints
    [Capstone-2025.SchLib]
2024-05-23 Test Pytohn script to talk to ESP board!!!
2024-09-16 make directory names lower case (#1)
    [Block-Diagram.SchDoc, Capstone-2025.PcbLib, Capstone-2025.PrjPcb, Capstone-2025.SchLib]
2024-10-08 Fix library file structure
    [Block-Diagram.SchDoc, Capstone-2025.PcbLib, Capstone-2025.PrjPcb, Capstone-2025.SchLib]
2024-10-09 Finish block diagram, add shit ton of components to library
    [Block-Diagram.SchDoc, Capstone-2025.PcbLib, Capstone-2025.SchLib, PuttPilot-Dev.PrjPcb, PuttPilot.PcbLib, PuttPilot.SchLib]
2024-10-09 Add schematic placeholders
    [ESP8266.SchDoc, PWM_CONTROL.SchDoc, Power.SchDoc, PuttPilot-Dev.PrjPcb, USB_TO_UART.SchDoc]
2024-10-09 Add QFN and SOP USB to UART
    [Power.SchDoc, PuttPilot.PcbLib, PuttPilot.SchLib]
2024-10-12 Several library additions
    [PuttPilot.PcbLib, PuttPilot.SchLib]
2024-10-12 More library additions
    [PuttPilot.PcbLib, PuttPilot.SchLib]
2024-10-13 Final library components. Started dropping components on sheets
    [Block-Diagram.SchDoc, Power.SchDoc, PuttPilot.PcbLib, PuttPilot.SchLib, USB_TO_UART.SchDoc]
2024-10-14 Add PuttPilot sheet templates
    [Block-Diagram.SchDoc, ESP8266.SchDoc, PWM_CONTROL.SchDoc, Power.SchDoc, PuttPilot.SchLib, USB_TO_UART.SchDoc]
2024-10-14 Power schematic complete
    [Block-Diagram.SchDoc, ESP8266.SchDoc, PWM_CONTROL.SchDoc, Power.SchDoc, PuttPilot.PcbLib, PuttPilot.SchLib, USB_TO_UART.SchDoc]
2024-10-14 USB to UART schematic done
    [Power.SchDoc, PuttPilot-Dev.PrjPcb, PuttPilot.SchLib, USB_TO_UART.SchDoc]
2024-10-14 ESP and I2C preliminary pages done
    [ESP8266.SchDoc, PWM_CONTROL.SchDoc, Power.SchDoc, USB_TO_UART.SchDoc]
2024-10-15 PWM headers, hierarchal page, and PWM LED grid
    [ESP-Power.SchDoc, Hierarchal-Power.SchDoc, PWM_CONTROL.SchDoc, Power.SchDoc, PuttPilot-Dev.PrjPcb, PuttPilot.PcbLib, PuttPilot.SchLib]
2024-10-15 start layout
    [ESP-Power.SchDoc, ESP8266.SchDoc, Hierarchal-Power.SchDoc, PWM_CONTROL.SchDoc, PuttPilot-Dev.PcbDoc, PuttPilot-Dev.PrjPcb, PuttPilot.PcbLib, PuttPilot.SchLib]
2024-10-15 Ideal 6A buck layout
    [PuttPilot-Dev.PcbDoc]
2024-10-16 Add ESP footprint and edit silk screen on passives
    [ESP-Power.SchDoc, ESP8266.SchDoc, Hierarchal-Power.SchDoc, PWM_CONTROL.SchDoc, PuttPilot-Dev.PcbDoc, PuttPilot.PcbLib, PuttPilot.SchLib, USB_TO_UART.SchDoc]
2024-10-16 Remaining components. Layout progress
    [ESP-Power.SchDoc, ESP8266.SchDoc, Hierarchal-Power.SchDoc, Hierarchal.SchDoc, PWM_CONTROL.SchDoc, PuttPilot-Dev.PrjPcb, PuttPilot.PcbLib, PuttPilot.SchLib]
2024-10-17 Modify rules to get rid of some DRCs
    [ESP-Power.SchDoc, ESP8266.SchDoc]
2024-10-20 I2C changes with RJ45. So many other freaking changes holy shit
    [ESP-Power.SchDoc, ESP8266.SchDoc, Hierarchal.SchDoc, PWM_CONTROL.SchDoc, PuttPilot-Dev.PrjPcb, PuttPilot.PcbLib, PuttPilot.SchLib, USB_TO_UART.SchDoc]
2024-10-20 Add components on board!!
    [ESP8266.SchDoc, PuttPilot.SchLib]
2024-11-10 Shit ton of routing. Added MUX, I2C config resistors
    [Block-Diagram.SchDoc, ESP-Power.SchDoc, ESP8266.SchDoc, PWM_CONTROL.SchDoc, PuttPilot-Dev.PrjPcb, PuttPilot.PcbLib, PuttPilot.SchLib, USB_TO_UART.SchDoc]
2024-11-11 soooooo close
    [PWM_CONTROL.SchDoc, PuttPilot.PcbLib, USB_TO_UART.SchDoc]
2024-11-12 Clean GND antennas and more stitching
    [PuttPilot-Dev.DRL, PuttPilot-Dev.GBL, PuttPilot-Dev.GBO, PuttPilot-Dev.GBP, PuttPilot-Dev.GBS, PuttPilot-Dev.GKO, PuttPilot-Dev.GTL, PuttPilot-Dev.GTO]
2024-11-13 Add GND planes to L2, L3. Final gerbers generated. PCB ORDERED!
    [PuttPilot-Dev.DRL, PuttPilot-Dev.GBL, PuttPilot-Dev.GBO, PuttPilot-Dev.GBP, PuttPilot-Dev.GBS, PuttPilot-Dev.GKO, PuttPilot-Dev.GTL, PuttPilot-Dev.GTO]
2025-01-03 WIP start bringing up i2c and pca9685, not sure if compiling
2025-01-03 WIP start populating i2c and pca9685 driver
2025-01-03 WIP continuing developing driver
2025-01-03 add empty actuator file, not sure if compiles
2025-01-03 WIP add ADC files
2025-01-03 WIP start implementing ADC and MUX
2025-01-03 WIP work on actuator control
2025-01-03 blinky main code, commented out wifi init so it doesn't block when it can't connect to wifi
    [main.c]
2025-01-07 get LED working for one of the boards, use 0x47 for other
2025-01-07 modify PCA9685 driver to work with servos and leds
2025-01-07 led and servo pwms working on one board
2025-01-15 dev board schematic and layout complete
    [Block-Diagram.SchDoc, ESP-Power.SchDoc, ESP8266.SchDoc, Hierarchal.SchDoc, PWM_CONTROL.SchDoc, PuttPilot-Dev.PrjPcb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]
2025-01-15 Clean up traces and fix hole DRCs
2025-01-16 Master and node projects created (#15)
    * Create master board and fix room generation for master
    * Fix sheet templates and room generation for Dev PCB
    * Create node and remove unneccesary components
    * Footprint/library updates based on dev testing
    [Block-Diagram.SchDoc, Connectors.SchDoc, ESP-Power.SchDoc, ESP8266.SchDoc, Hierarchal.SchDoc, PWM-Power.SchDoc, PWM_CONTROL.SchDoc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]
2025-01-16 update adc code
2025-01-16 update actuator control to new control scheme, UNTESTED
2025-01-16 get static actuator control working well and integrated with http requests, tested and working
2025-01-16 add motor startup sequence and move wifi init to top
2025-01-17 Node layout prigress
    [Connectors.SchDoc, Hierarchal.SchDoc, PWM-Power.SchDoc, PuttPilot-Node.PrjPcb, Servo-Power.SchDoc]
2025-01-17 Route everything. 0 DRCs
    [Connectors.SchDoc, PWM-Power.SchDoc, PuttPilot.PcbLib]
2025-01-17 add some more silkscreen and increase font on node
    [PuttPilot-Node.PrjPcb]
2025-01-17 add more silkscreen
2025-01-17 update master esp8266 schematic
    [ESP8266.SchDoc, PuttPilot.SchLib, USB_TO_UART.SchDoc]
2025-01-17 Schematic changes and layout tear apart
    [ESP-Power.SchDoc, ESP8266.SchDoc, Hierarchal.SchDoc, PWM_CONTROL.SchDoc, PuttPilot-Master.PrjPcb, PuttPilot.PcbLib, PuttPilot.SchLib, Servo-Power.SchDoc]
2025-01-17 Final master schematic changes
    [ESP8266.SchDoc]
2025-01-20 Via stiching and polygon cleanup - Node
    [PuttPilot-Dev.PrjPcb, PuttPilot-Node.PrjPcb]
2025-01-20 Fix stiching on node. Layout progress on master
    [ESP8266.SchDoc, Hierarchal.SchDoc]
2025-01-20 Master buck layout done
    [PuttPilot.PcbLib]
2025-01-20 Master layout progress
    [USB_TO_UART.SchDoc]
2025-01-20 Sensor headers laid out
2025-01-20 Master routing progress. Fix some Node SI
    [ESP8266.SchDoc, Hierarchal.SchDoc]
2025-01-20 Route master PWMs
    [PuttPilot.PcbLib]
2025-01-20 Essentially done
    [ESP8266.SchDoc, PuttPilot-Master.PrjPcb]
2025-01-20 Generate gerbers for node and master. Boards ordered!!
    [PuttPilot-Master.PrjPcb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]
2025-02-01 button styling
2025-02-02 button functionality
2025-03-22 slightly update control scheme to free up servo slot for continous motor and add comments
2025-03-22 WIP skeleton code for sensors task
2025-03-22 WIP, continue working on sensors
2025-03-22 WIP create non blocking delay functions, didn't try to compile
    [delay.c, delay.h]
2025-03-22 WIP continune working on sensor, didn't try to compile yet
    [delay.c, delay.h, gpio.h, sensors.c]
2025-03-22 add macro for sensors.c
2025-03-22 add simple continuous servo controls, untested, un-compiled
2025-03-22 fix compilation errors, app not working
    [actuator_control.c, ball_estimation.h, ball_queue.c, ball_queue.h, delay.c, delay.h, main.c, sensors.c]
2025-03-22 Threads running, I think, LED blinks, compiles, untested for functionality
2025-03-22 add blinking LED
2025-03-22 fix addressing and update script a bit
    [actuator_control.c]
2025-03-22 add comments, rework statemachines, update logging, untested, compiled
    [ball_estimation.c, sensors.c, wifi_handlers.c]
2025-03-22 add more comments and fix some logic, untested, compiled
    [ball_estimation.c, ball_queue.c]
2025-03-22 fix some logic, test on protoboard -- all sensor working and flow as expected, tested, compiles
    [ball_estimation.c, ball_estimation.h, ball_queue.c, gpio.c, sensors.c, wifi_handlers.c]
2025-03-22 add error codes to be sent over http, tested, compiles
    [ball_estimation.c, ball_queue.c, error_codes.c, error_codes.h, wifi_handlers.c]
2025-03-22 add NVS support to save course state, semi tested but not with real motors
2025-03-22 add error codes for NVS
    [user_nvs.c]
2025-03-22 increase delay between rollout groups to decrease current draw
2025-03-22 decrease actuator control rollout time
2025-03-22 fix player ball queue bugs
    [ball_queue.c]
2025-03-22 tuning of delays in ball queue and debounce in sensors
